VK2ARH/NTP-Clock/README.md

**Update 20 July 2026**

Latest software and software manual can be found in the respective folders to support v2.7 boards with significant uplift in capability. Latest software release now version 4.x

**Update 6th July 2026 - New hardware layout v2.7b gerbers and construction manual update**

There have been significant upgrades undertaken with this project and the new functionality is introduced in the construction manual in the documents folder. This functionaliy includes GPS support, automatic Maidenhead calculation, OpenWeatherMap API calls, solar weather, LiPo battery, increased power options and a significantly updated Web Based configuration tool via the ESP32-S2 Mini's AP. The v2.7b hardware version of the clock is intented to operate whilst connected to a WiFi network (ie: in the shack) or when operating remotely (eg: POTA) and uses GPS for time synchronisation and location details when remote. The clock is also wired to take advantage of the TFT Screen's 'touch screen' capabilties to support future software developement.

Whilst supporting a range of new capabilties, the clock can be built in its 'basic' form to operate from a USB-C 5v power supply without the use of GPS or additional Power supply options or environmental monitors.
This is the project being built by the Manly Warringah Radio Society (MWRS - Sydney NWS), Cowtown Amateur Radio Club (Fort Worth, TX USA) and the Radio and Electronics Society of Southern Tasmania (Hobart, Tasmania) in their builthathon programs in 2026. The software to support this new capabitlity is in the final stages of testing and is expected to be released shortly.

The following YouTube video records a presentation I gave recently to the MWRS and provides good background to the improvements and increased capabilities of the clock.

https://youtu.be/coA3r7XgQvE?si=FMj0u2H3OHRHAzfh



**___________________________________________________________________________________________________________**

**Update 8th April 2026 - New Software, hardware layout and construction manual to be issued later this month**
If you are planning to build this project - I recommend that you delay a couple of weeks to take advantage of new board and software capabilities.

**Update 28 Dec 25, New updated software v2.5.35 and Manual available** - see software directory for details
This is a minor update which includes the ability to display Weather data (Temp, Humidity, Pressure) from the optional onboard BME280 sensor if fitted. Note this is only a preliminary release and the display is currently only using Celcius and haPa units at this stage.

**Update 30 Nov 25, New updated software v2.5 available** - see software directory for details



This repository holds the files used for the Bruce Hall W8BH NTP Clock which has been further developed by Richard VK2ARH together with contributions from a number of fellow Amateur Radio Operators who are acknowledged throughout the documentation.  The clock displays both local and UTC time derived and reqularly updated from an internet time server via wifi. The build project took Bruce's original BN33 PCB and added a top and bottom cover to house the clock board to support the CalQRP NTP Clock build in 2025.  The VK2ARH PCB then evoled through a series of changes to provide additional functionality (in conjunction with softwarwe development) whilst retaining the ability to operate as the same basic NTP clock developed by Bruce if the additional features are not required.The boards were developed to support the Manly Warringah Radio Society's build program in 2025 as a fun project to bring society members together and have some fun whilst building a practical addition to the 'shack'.

Documentation and Gerber files specifically for the MWRS build project are also included in this repository in the appropriate sub folder. The main construction manual for the project "**MWRS NTP CLock Build Notes**" can be found in the document folder and **should be read first** to guide you through the resources available and method for building the clock.



Bruce's website and additional information can be found here: http://w8bh.net/

The clock can be configured for any location by inserting the appropriate string in the code. This string identifies the offset from UTC and the day and times of changes to daylight savings (eg:2nd sunday of April at 2:00am). Details of where to find the string for your location is covered in the documentation. 

The clock takes about an hour to build and is a fun little project which delivers a great practical addition to the shack. 



Whilst the clock can be powered directly with a USB-C connection to the onboard ESP8266 module, Bruce's project made use of a buck converter to support a wide range of input voltages from 7-15v, making it ideal to be powered from a 13.8v power supply in the shack.

Full details of the capabilty of the clock, how to build and configure it are contained in the documentation. Further updates will be posted here should any update to the software or gerber files become availble. The software is open source so feel free to improve or modify the code. 

The W8BH PCB enables the use of either a 2.2", 2.8" or 3.2" screen. This build uses the 2.8" LCD screen as it was chosen as the perceived best price/screen size option, although it does requires the removal of some PCB material around the mounting holes of the 2.8" display board to provide clearance for the standoffs to mount the display in the 'PCB sandwich' housing. This trimming of the display PCB can be done with confidence knowing that there are no tracks around the mounting holes. 

The holes on a 3.2" LCD display align perfectly with the W8BH PCB holes and the use of a 2.2" board will allow the mounting spacers to be used without any modification to the 2.2" board, but in both these cases a different top cover would be required to align with the display. My recommendation - stick with the 2.8" screen if you wish to use the top cover, but I have added a 3.2" display top cover - see the gerber subdirectory for details.

The standoffs between the PCB and Bottom cover are 15mm and 16mm (15mm + 1mm Plastic washer)between the Top Cover and the PCB. The build could be made thinner if components were soldered directly to the main PCB, but if you are happy to do that, simply adjust the size of the spacers between the boards.



Simon VK2YU designed a great 3D printed housing for the NTP clock using the top cover shown in this project. The link to the .stl files in Thingiverse can be found here: https://www.thingiverse.com/thing:7013343  Thanks Simon :) 
