VK2ARH/NTP-Clock/Documentation/README.md

**Update 26th July 2026 - New Software Manual for Version 4 software Uploaded**

A copy of Mark Culross KD5RXT's software manual for the NTP Clock has been added to this repository. You should always check Marks repository for any futher updates to this manual and the Clock Software.

https://github.com/mjculross/NTPclock-for-MWRS-CARC-REAST

**Update 17th July 2026 - New V2.7b Version 1.0 - Initial Release Contruction Manual Uploaded**

The latest construction manual for the V2.7 board has been released. This is a comprehensive construction manual and should be all you need in order to construct the clock. Addititional documentation including legacy documents are also to be found in this repository.

The latest version of the software v4.x has been uploaded to the software sub directory

**Update 6th July 2026 - New V2.7b construction manual - Initial Draft**

The initial draft manual for the v2.7b hardware. This manual also outlines the upgrades made to the NTP Clock and the increased functionalilty and capabilities. A corresponding sofware manual will be issued in the next few weeks to provide details associated with the operation and loading of the latest software to augment the v2.7b clock. The construction manual and the associated software manual (still to be uploaded) are standalone and no other documentation is required to build and operate the V2.7b clock.



This folder contains documentation associated with the NTP Clock build - primarily to support the Manly Warringah Radio Society (MWRS) project developed by Richard VK2ARH. The principal build document for this project is **MWRS NTP Clock Build Notes v2.x.pdf** this should be read first. The MWRS NTP Clock Build Notes v1.x.pdf previously released related to the the earlier version of the board that was used during the MWRS Build Project which has now been supersceded by the V2.1 board with its additional capabilities. 

This project is drawn from the NTP clock developed by Bruce Hall W6BH and a wealth of information relating to this project can be found on his website : http://w8bh.net/

Bruce Halls documentation specific to his original project consists of the following:
-  **NTP_DualClock.pdf** – Provides the background to the operation and programming of the firmware for the NTP Clock
-  **NTP_clock_build Instructions.pdf** – A detailed construction manual of how to build the NTP clock using Bruce’s original PCB provided for the project. NOTE: These are different to the MWRS PCB's
-  **CalQRP_Club_-_NTP_Clock_ReadMeFirst 2025-04-04.pdf** This document provides a series of guidelines provided to the California QRP Club who built the project in April 25 using Bruce Hall’s original project PCB’s. These guidelines relate to configuring the timezone for the USA, so read how to configure the Australian Time Zones later in this document.
-  **How to install the ESP8266 Board into Arduino IDE.pdf** The title is self explanatory. You will be uploading the firmware for this project to a WEMOS D1 mini microcontroller, and this document shows you how to set up the Arduino IDE environment to work with this board.
-  **VK2ARH NTP Clock Schematic.pdf** - it the schematic diagram used for the MWRS PCB version 1.
-  **VK2ARH NTP Clock Schematic v2.1.pdf** the schematic for the latest NTP Clock PCB.
