VK2ARH/NTP-Clock/Gerbers/W8BH Original PCBs/readme.md

This folder holds the gerber files for the original NTP clock developed by Bruce Hall W8BH.

The BN33 variant is the board used by the CalQRP club for their NTP clock project in 2025.
