VK2ARH/NTP-Clock/Gerbers/VK2ARH_Version_2/readme.md

This directory contains the lates VK2ARH version 2 boards for the NTP Clock. The main PCB and a top and bottom cover. The build notes for the version 2 board can be found in the documents folder of this repository.



Top and Bottom Covers:
