VK2ARH/NTP-Clock/Gerbers/VK2ARH_Version_1/readme.md

This directory contains the gerber files for VK2ARH PCB variant version 1 - used by the MWRS, together with the top and bottom covers used in the project with a 2.8" screen. This latest board includes support for and ESP32 Zero and a number of push button switches and a LDR/resistor to support further software development and experimentation. Dimming capabiity both manual and automatic has been added to the firmware by Mark KD5RXT and the latest version of this software taking advantage of these additional components on the main board can be found in the Sofware sub folder.
