VK2ARH/NTP-Clock/Documentation/How to install the ESP8266 Board into Arduino IDE.pdf

How to add ESP8266 board into Arduino IDE

These notes will assist you installing the necessary board library into the Arduino IDE to use the WSP8266 LOLIN(Wemos) D1 R2 and Mini board. The ESP8266 is a cheaper and fit for purpose board for use in the build. It is pin compatible with the W8BH main board.
For instructions as to how to manually add a new board library to the Arduino IDE go to:
Add third-party platforms to the Boards Manager in Arduino IDE – Arduino Help Center https://support.arduino.cc/hc/en-us/articles/360016466340-Add-third-party-platformsto-the-Boards-Manager-in-Arduino-IDE
Follow the instructions and add the following URL http://arduino.esp8266.com/stable/package_esp8266com_index.json

Once installed the LOLIN(Wemos) D1 R2 and Mini board will be an option in the

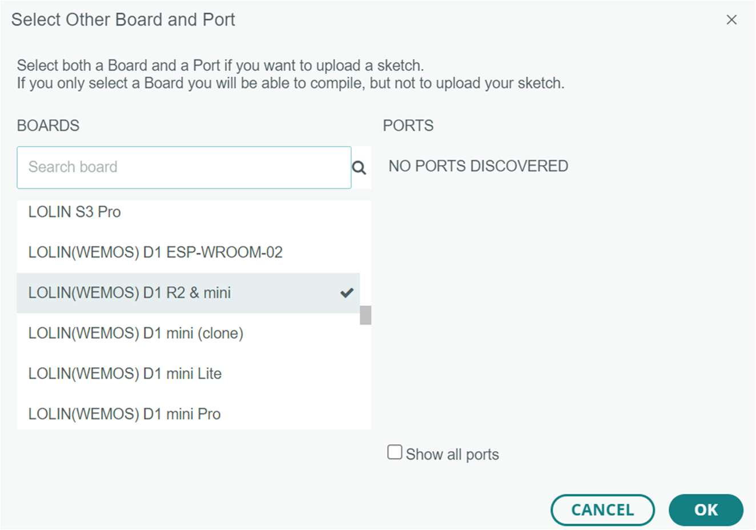
[picture p15: figure]

Then go back and select:
