VK2ARH/NTP-Clock/Documentation/NTP_clock_schematic v2_1.pdf

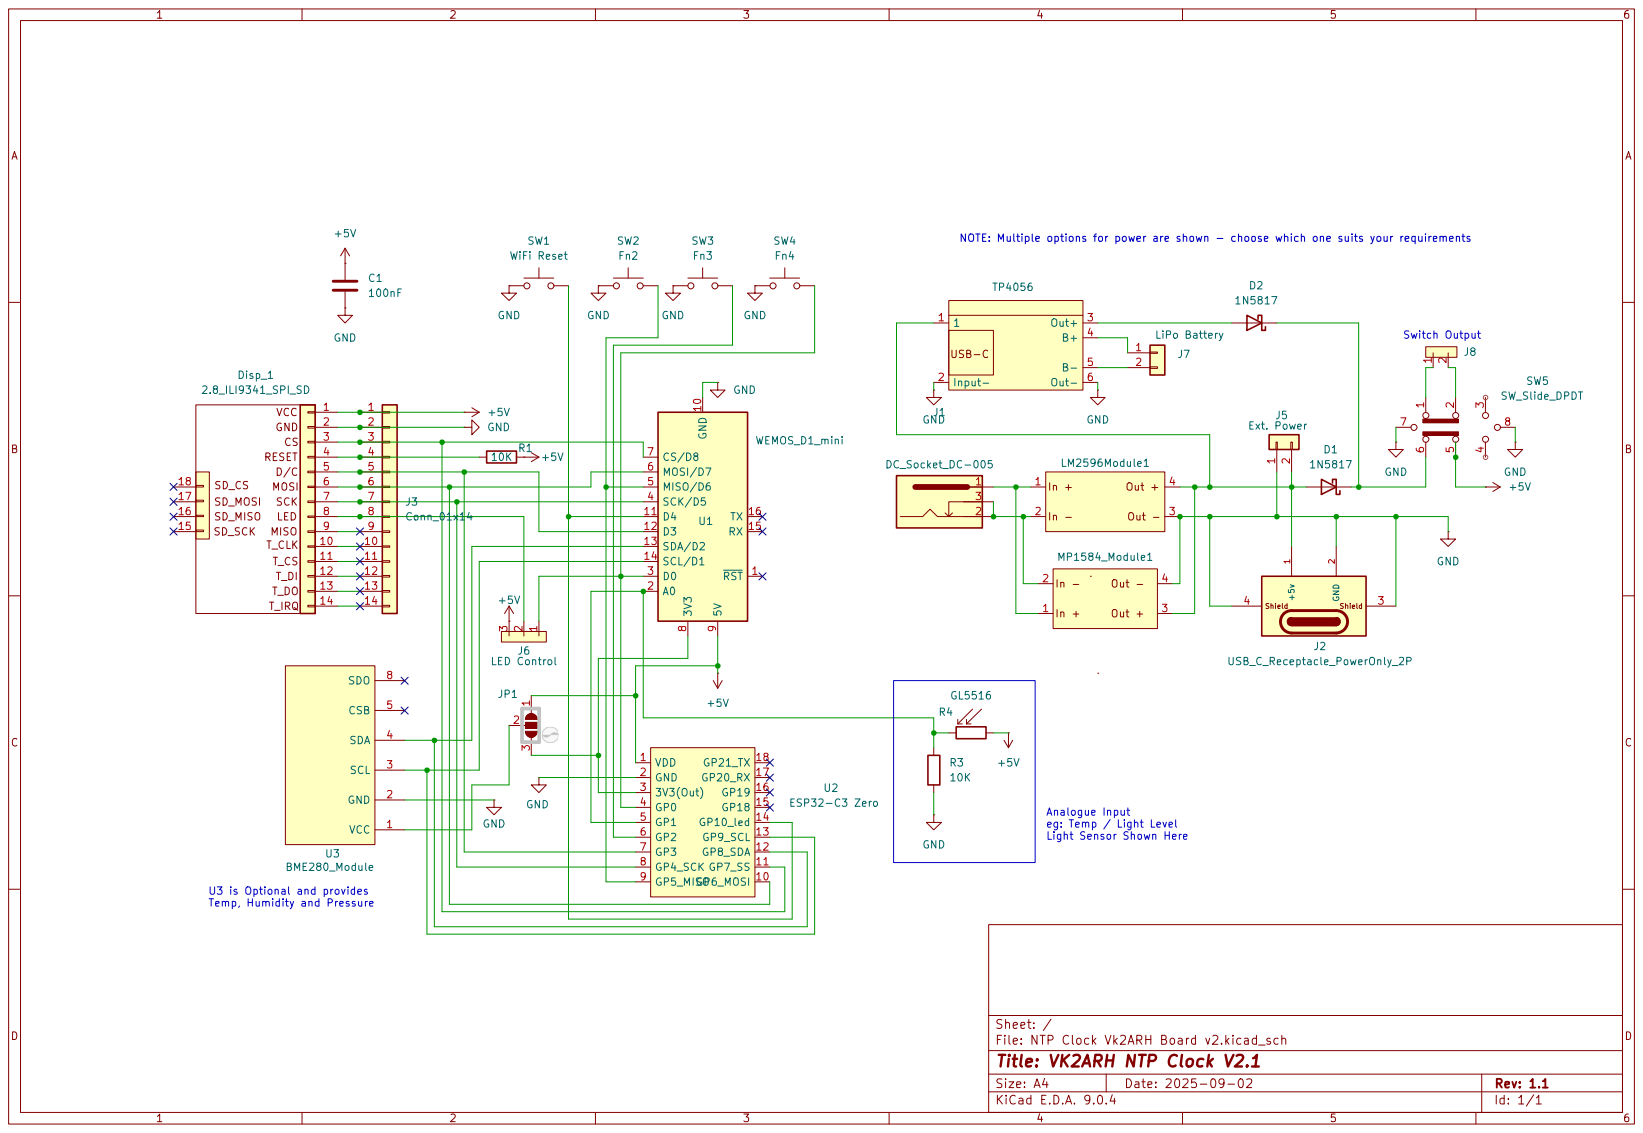
[picture p28: page 1]
