VK2ARH/NTP-Clock/Documentation/VK2ARH NTP Clock Schematic.pdf

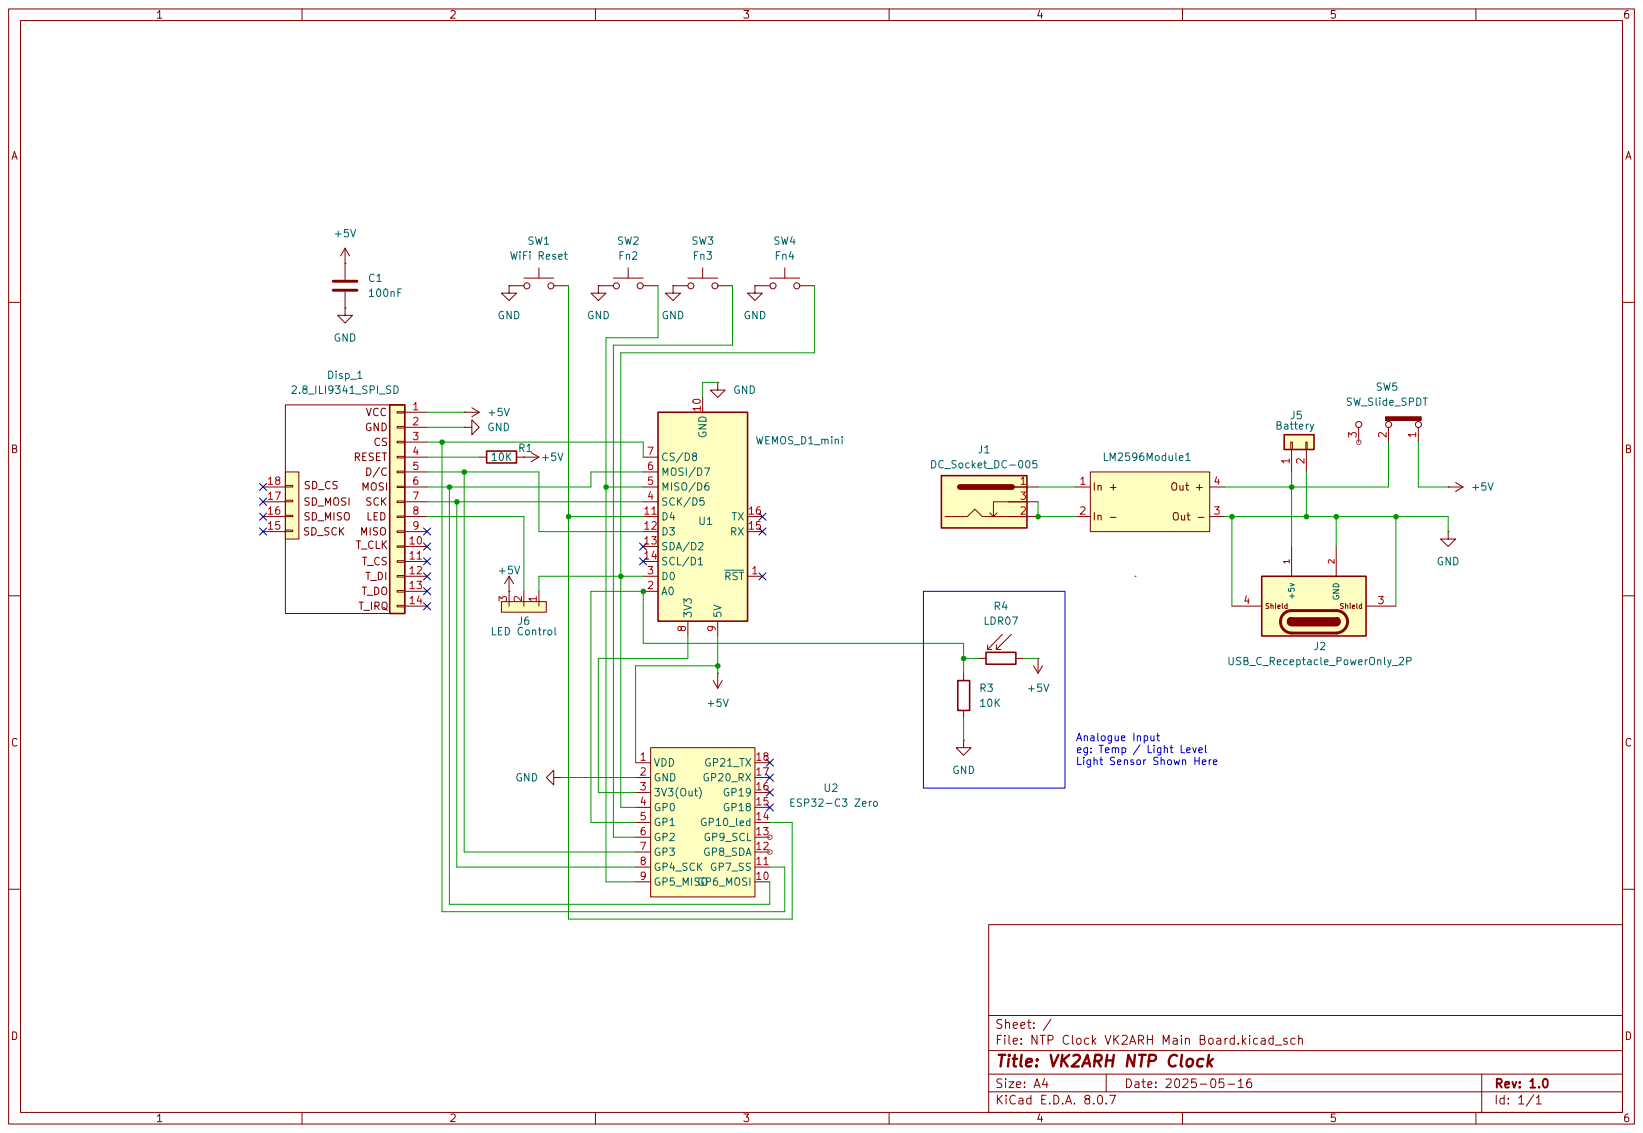
[picture p29: page 1]
