VK2ARH/NTP-Clock/(commit log)

2025-04-19 Update README.md
    Added link to Simon VK2YU's 3D printed case to house the NTP Clock.
2025-04-19 Add files via upload
    Latest Gerber files added with minor correction to the size of the opening on the top cover for the 2.8" display. (Narrowed by 1mm at the bottom of the opening).
2025-10-31 Add VK2ARH PCB variant gerber files and details
    Uploaded gerber files for VK2ARH PCB variant, including details about the board's features and images.
2025-10-31 Update readme for VK2ARH PCB variant version 1
2025-10-31 Update readme with details on NTP clock covers
    Added detailed information about the gerber files for the NTP clock covers, including display options and design notes.
2025-10-31 Update board reference in readme.md
2025-10-31 Update README with VK2ARH Version 2 details
    Added details about VK2ARH Version 2 gerber files and their usage.
2025-10-31 Update readme with VK2ARH version 2 details
    Added description and images for VK2ARH version 2 boards.
2025-10-31 Clean up README.md by removing old updates
    Removed outdated information and images related to the VK2ARH PCB variant and its features.
2025-10-31 Revise README for NTP Clock project updates
    Updated documentation to reflect changes in the NTP Clock project, including the new version of the build notes and additional schematic files.
2025-12-04 Add files via upload
    Updated construction notes for the v2.1 PCB and v2.5 software
2025-12-28 Add weather data display feature in v2.5.35
    This update introduces the ability to display weather data from the BME280 sensor. It is a preliminary release with limited unit support.
2026-07-06 Update README with version 2.7b board details
    Added information about version 2.7b boards and their features, including support for NTP/GPS clock functionality and new hardware specifications.
2026-07-26 Add files via upload
    Version 4_1_2 adds support for the ESP32-S3 Mini
